fredsa/apple-color-monitor-iie-a2m2056/photos/power-pcb-bottom-flipped.jpg

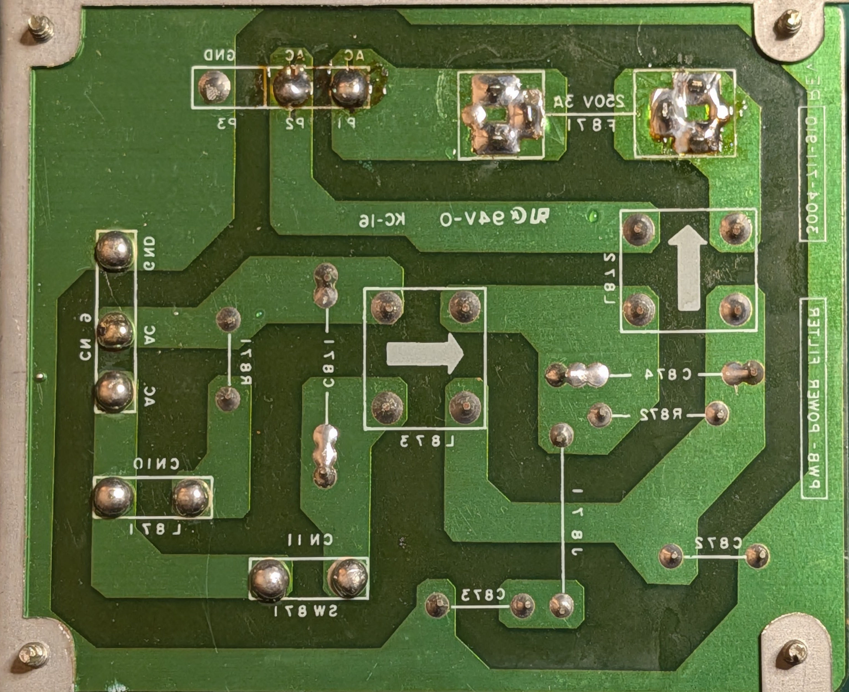
photos/power-pcb-bottom-flipped.jpg
