fredsa/apple-color-monitor-iie-a2m2056/photos/power-pcb-top.jpg

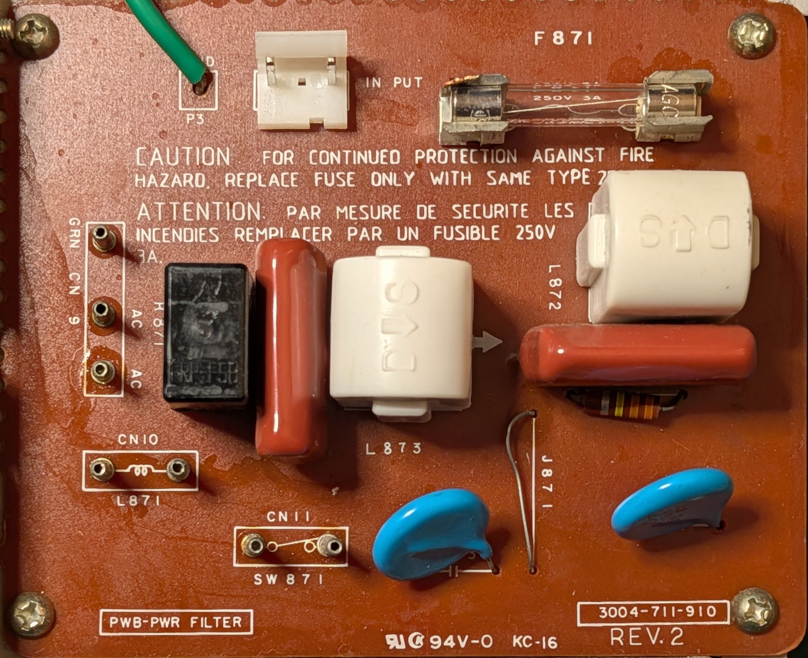
photos/power-pcb-top.jpg
