fredsa/apple-color-monitor-iie-a2m2056/apple-color-monitor-iie-a2m2056.pdf

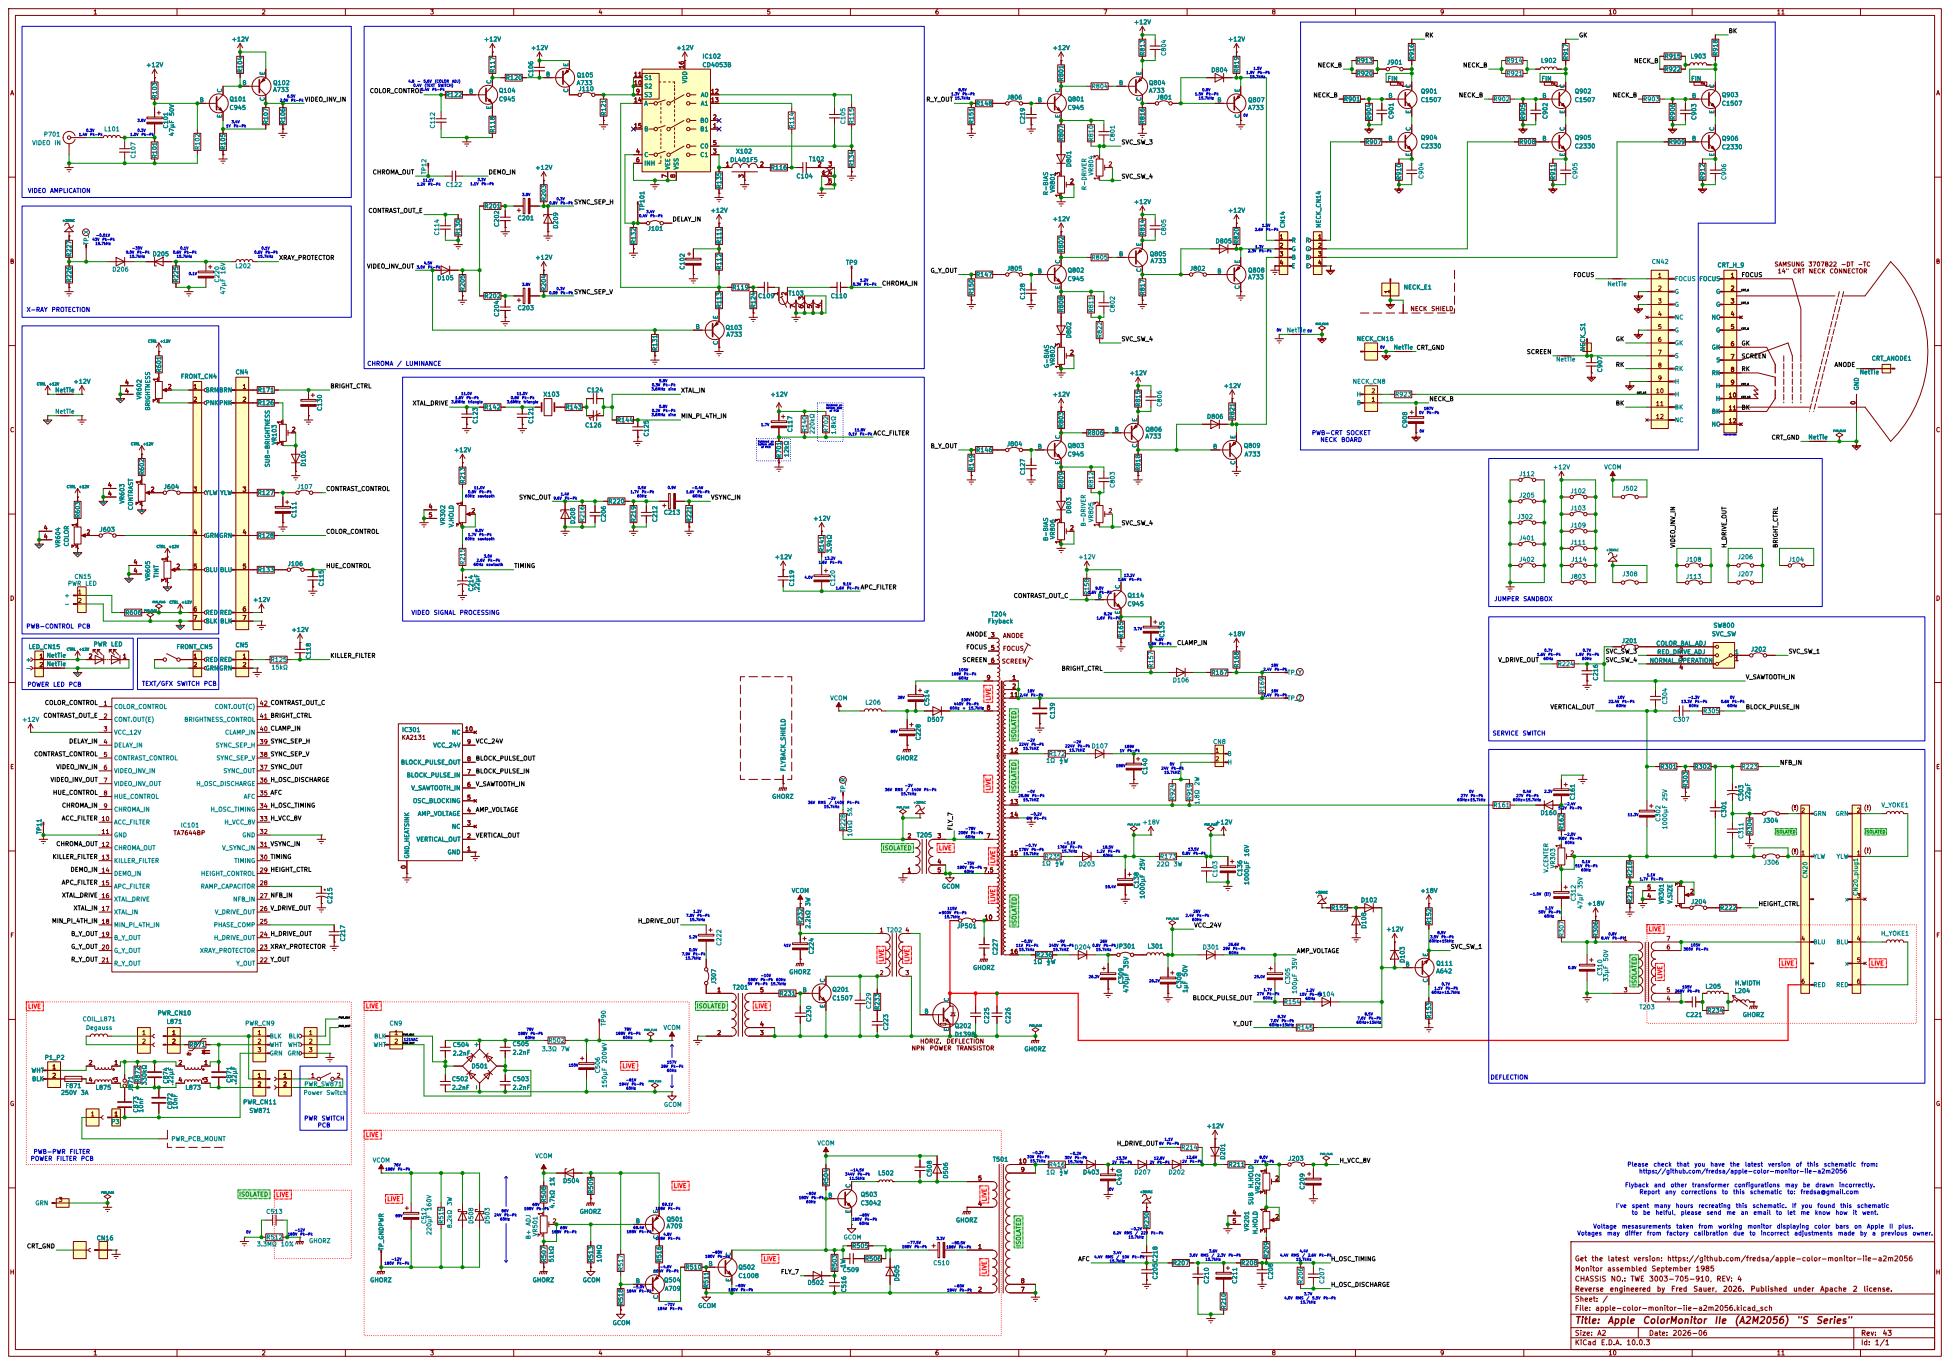
[picture p8: page 1]

8.5V 1.3V Pk-Pk 15.7kHz 0.3V 0.08 Pk-Pk

13.2V 1.6V Pk-Pk 4.0V CHROMA / LUMINANCE

Soldered on
bottom side of PCB

PWB-CRT SOCKET NECK BOARD

PWR_FLAG SW800

Soldered on bottom side of PCB

18V 2.4V Pk-Pk 8.0V 1.7V Pk-Pk 60Hz sawtooth

3.0V 2.6V Pk-Pk 60Hz sawtooth VIDEO SIGNAL PROCESSING

TEXT/GFX SWITCH PCB

0V 0.6V Pk-Pk 60Hz -10V 186V Pk-Pk 60Hz 5V Pk-Pk 15.7kHz41V

0.4V 27V Pk-Pk 60Hz+15.7kHz 1.7V 27V Pk-Pk 60Hz

GHORZ

-80V 184V Pk-Pk PWR SWITCH
PCB

Please check that you have the latest version of this schematic from: https://github.com/fredsa/apple-color-monitor-iie-a2m2056

Flyback and other transformer configurations may be drawn incorrectly.
Report any corrections to this schematic to: fredsa@gmail.com

I've spent many hours recreating this schematic. If you found this schematic

to be helful, please send me an email to let me know how it went. Voltage mesasurements taken from working monitor displaying color bars on Apple II plus.

Votages may differ from factory calibration due to incorrect adjustments made by a previous owner.

Get the latest version: https://github.com/fredsa/apple-color-monitor-iie-a2m2056
Monitor assembled September 1985
CHASSIS NO.: TWE 3003-705-910, REV: 4
Reverse engineered by Fred Sauer, 2026. Published under Apache 2 license.
Sheet: /
File: apple-color-monitor-iie-a2m2056.kicad_sch
Title: Apple ColorMonitor IIe (A2M2056) "S Series"

Size: A2 | Rev: 43
KiCad E.D.A. 10.0.3 | Id: 1/1
