fredsa/apple-color-monitor-iie-a2m2056/KiCad/apple-color-monitor-iie-a2m2056/apple-color-monitor-iie-a2m2056.kicad_pcb.pdf

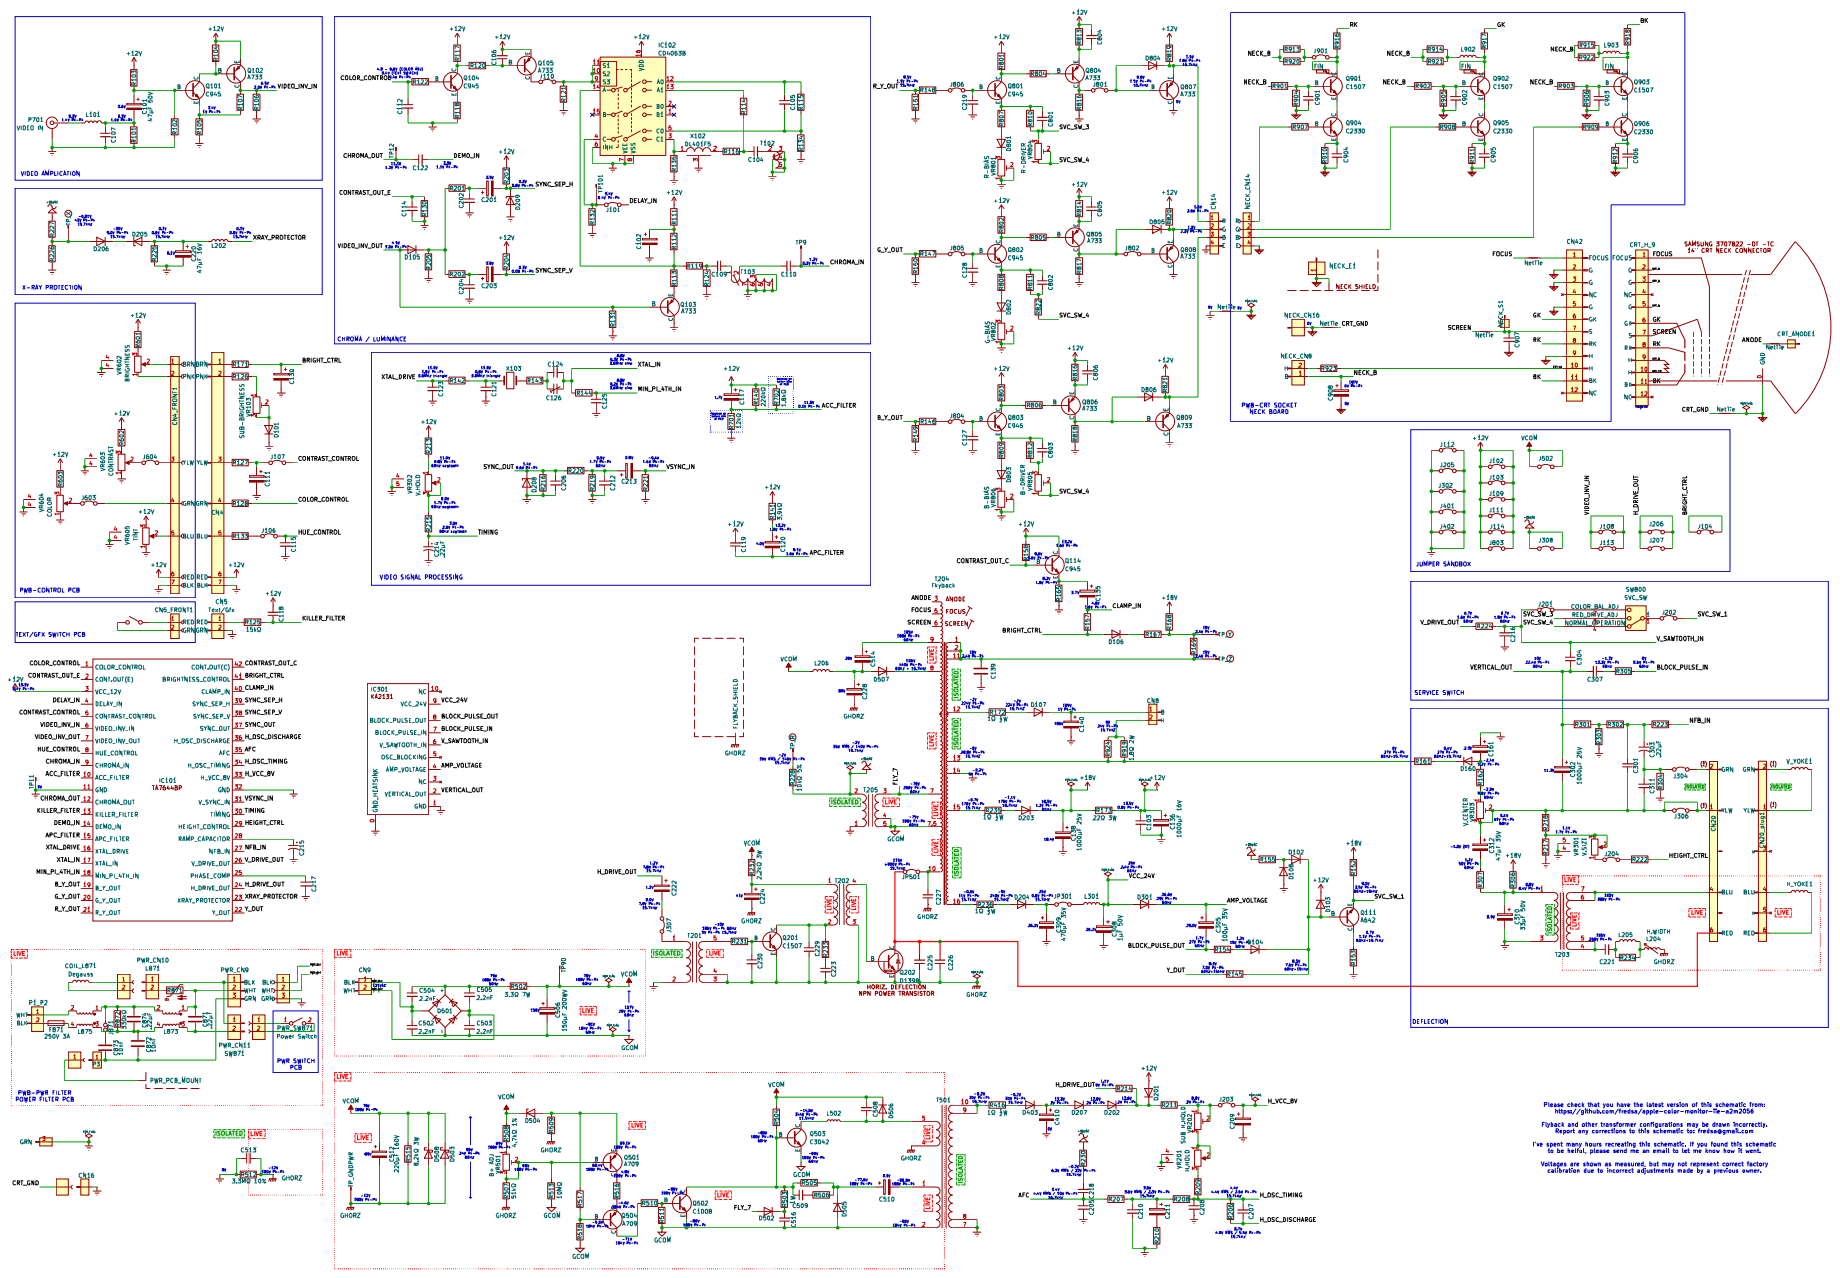
[picture p9: page 1]
