fredsa/apple-color-monitor-iie-a2m2056/KiCad/apple-color-monitor-iie-a2m2056/apple-color-monitor-iie-a2m2056.kicad_sch

## KiCad design KiCad/apple-color-monitor-iie-a2m2056/apple-color-monitor-iie-a2m2056.kicad_sch (2026-06-29)

Schematic: apple-color-monitor-iie-a2m2056.kicad_sch

Parts:
C101: 47µF 50V; CP_Radial_D5.0mm_P5.00mm
C102, C111, C117, C120, C130, C135, C140, C161, C222, C224, C410, C514: C; CP_Radial_D8.0mm_P5.00mm
C103, C104, C105, C106, C107, C109, C110, C112, C114, C115, C118, C119, C121, C122, C123, C124, C125, C127, C128, C202, C204, C205, C206, C207, C208, C210, C212, C216, C217, C218, C219, C301, C304, C307, C311, C801, C802, C803, C804, C805, C806: C_Small; R_Axial_DIN0204_L3.6mm_D1.6mm_P5.08mm_Horizontal
C126: C_Trim_Small; R_Axial_DIN0204_L3.6mm_D1.6mm_P5.08mm_Horizontal
C136: 1000µF 16V; CP_Radial_D10.0mm_P5.00mm
C138: 1000µF 25V; CP_Radial_D12.5mm_P7.50mm
C139: C; C_Axial_L3.8mm_D2.6mm_P12.50mm_Horizontal
C201, C203, C209, C211, C213, C908: C; CP_Radial_D5.0mm_P5.00mm
C214, C303: .22µF; CP_Radial_Tantal_D4.5mm_P5.00mm
C215: C; CP_Radial_Tantal_D4.5mm_P5.00mm
C220: 47µF 16V; CP_Radial_D5.0mm_P5.00mm
C221: C_Small; R_Axial_DIN0309_L9.0mm_D3.2mm_P20.32mm_Horizontal
C223, C229, C230: C_Small; C_Rect_L7.0mm_W2.5mm_P5.00mm
C225, C227: C_Small; C_Rect_L16.5mm_W4.9mm_P15.00mm_MKT
C226, C508, C509: C_Small; C_Disc_D10.0mm_W2.5mm_P5.00mm
C228: C; CP_Radial_D10.0mm_P7.50mm
C302: 1000µF 25V; CP_Radial_D10.0mm_P7.50mm
C305: 100µF 35V; CP_Radial_D8.0mm_P5.00mm
C308: 1µF 50V; CP_Radial_D8.0mm_P5.00mm
C309: 470µF 35V; CP_Radial_D10.0mm_P5.00mm
C310: 33µF 50V; CP_Radial_D8.0mm_P5.00mm
C312: 47µF 35V; CP_Radial_D8.0mm_P5.00mm
C502, C503, C504, C505: 2.2nF; C_Rect_L10.0mm_W2.5mm_P7.50mm_MKS4
C506: 150µF 200WV; CP_Radial_D16.0mm_P7.50mm
C510: C; CP_Radial_D8.0mm_P3.80mm
C512: 220µF 160V; CP_Radial_D16.0mm_P7.50mm
C513: C_Small; C_Rect_L9.0mm_W2.5mm_P7.50mm_MKT
C516: C_Small; C_Disc_D12.0mm_W4.4mm_P7.75mm
C871, C874: .22µF; R_Axial_Power_L20.0mm_W6.4mm_P25.40mm
C872, C873: 10nF; C_Axial_L3.8mm_D2.6mm_P10.00mm_Horizontal
C901, C902, C903, C904, C905, C906: C_Small; _C_Axial_P5.0mm
C907: C_Small; R_Axial_DIN0204_L3.6mm_D1.6mm_P7.62mm_Horizontal
CN4: Conn_01x07_Pin; _Molex_1x07_P2.54mm_Vertical
CN5: CN; Molex_KK-254_AE-6410-02A_1x02_P2.54mm_Vertical
CN8: Conn_01x02_Pin; SolderWire-0.127sqmm_1x02_P3.7mm_D0.48mm_OD1mm
CN9: Conn_01x02_Pin; _Conn_01x02
CN14: Conn_01x04_Pin; JST_XH_B4B-XH-AM_1x04_P2.50mm_Vertical
CN15: PWR LED; Molex_KK-254_AE-6410-02A_1x02_P2.54mm_Vertical
CN16: Conn_01x01_Pin; Pin_D1.0mm_L10.0mm
CN20: Conn_01x06_Pin; _CN20_pins
CN20_plug1: Conn_01x06
CN42: -crt-neck
COIL_L871: Degauss
CRT_ANODE1: Conn_01x01_Pin
CRT_GND1: Conn_01x01_Socket
CRT_H_9: Conn_01x12_Pin
D1: PWR LED
D101, D105, D106, D160: D; D_DO-15_P10.16mm_Horizontal
D102, D104, D108, D202, D207: D; D_DO-34_SOD68_P10.16mm_Horizontal
D103, D201: D; D_DO-34_SOD68_P12.70mm_Horizontal
D107, D301, D502, D506, D507: D; D_DO-15_P12.70mm_Horizontal
D203, D204, D403, D505: D; D_DO-15_P15.24mm_Horizontal
D205, D208, D209, D504: D_Zener; _ZenerDiode_P10mm
D206: D; _D_P14.5mm
D501: VALUE; _DiodeBridge
D503, D508: D_Schottky; _SchotkyDiode_P17.5mm
D801, D802, D803, D804, D805, D806: D; D_5W_P10.16mm_Horizontal
F871: 250V 3A; Fuseholder_Clip-6.3x32mm_Littelfuse_102071_Inline_P34.70x7.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
FRONT_CN4: CN; -connector_front_controls_01x07
FRONT_CN5: Conn_01x02_Socket
G_CN9: Conn_01x01_Pin; Pin_D1.0mm_L10.0mm
H_YOKE1: L
IC101: DIP-42_W15.24mm_LongPads
IC102: CD4053B; DIP-16_W7.62mm_LongPads
IC301: (no value)
J101, J102, J104, J106, J107, J114, J201, J202, J402, J604: Jumper_2_Bridged; _Jumper_11mm
J103, J401: Jumper_2_Bridged; _Jumper_12mm
J108, J109, J110, J111, J113, J302, J304, J306, J307, J308, J502, J803: Jumper_2_Bridged; _Jumper_13mm
J112, J204, J205, J206, J804, J805, J806: Jumper_2_Bridged; _Jumper_15mm
J203, J871: Jumper_2_Bridged; _Jumper_20mm
J207, J603, J801, J802: Jumper_2_Bridged; _Jumper_10mm
J901: Jumper_2_Bridged; _Jumper_4mm
JP301, JP501: Jumper_2_Bridged; _Jumper_13mm
L101, L205: L; L_Radial_D12.0mm_P6.00mm_Murata_1900R
L202: L; _L_Horiz_P6mm
L204: H.WIDTH; Potentiometer_Piher_PT-15-V02_Vertical
L206, L301: L; L_Radial_D12.5mm_P7.00mm_Fastron_09HCP
L502: L_Small; L_Axial_L11.0mm_D4.5mm_P15.24mm_Horizontal_Fastron_MECC
L873, L875: L_Coupled; _choke-pwr-board
L902, L903: L; _L_Axial_P5.0mm
LED_CN15: Conn_01x02_Socket
NECK_CN8: Conn_01x02_Pin; SolderWire-0.127sqmm_1x02_P3.7mm_D0.48mm_OD1mm
NECK_CN14: Conn_01x04_Socket; Molex_KK-254_AE-6410-04A_1x04_P2.54mm_Vertical
NECK_CN16: Conn_01x01_Pin; Pin_D1.0mm_L10.0mm
NECK_E1: Conn_01x01_Pin; -SolderWire
NECK_S1: Conn_01x01_Pin; -SolderWire
NECK_SH1: Metal Shield; Laird_Technologies_BMI-S-103_26.21x26.21mm
NT1, NT2, NT3, NT4, NT5, NT6, NT7, NT8, NT9, NT10: NetTie
P1_P2: IN PUT; -Connector_01x02XP10.0mm
P3: Conn_01x01_Pin; -SolderWire
P701: VIDEO IN; SMA_Amphenol_901-143_Horizontal
PWR_CN9: Conn_01x03_Pin; -Connector_01x03
PWR_CN10: L871; -Connector_01x02XP10.0mm
PWR_CN11: SW871; -Connector_01x02XP10.0mm
PWR_SW871: Power Switch
Q101, Q104, Q114, Q801, Q802, Q803: C945; -Transistor_EBC-NPN
Q102, Q103, Q105, Q804, Q805, Q806, Q807, Q808, Q809: A733; -Transistor_EBC-PNP
Q111: A642; -Transistor_EBC-NPN
Q201: C1507; TO-220-3_Vertical
Q202: D1398; TO-3P-3_Vertical
Q501, Q504: A709; -Transistor_EBC-PNP
Q502: C1008; -Transistor_EBC-NPN
Q503: C3042; _TO-3P-3_Vertical_BCE
Q901, Q902, Q903: C1507; -TO-220-3_Vertical-BCE_FIN
Q904, Q905, Q906: C2330; -Transistor_ECB-NPN
R101, R102, R103, R104, R105, R106, R107, R111, R112, R113, R114, R115, R116, R117, R118, R119, R120, R121, R124, R127, R128, R130, R131, R132, R133, R134, R135, R142, R143, R144, R149, R150, R151, R153, R155, R157, R161, R165, R168, R169, R171, R201, R202, R205, R206, R207, R208, R209, R210, R213, R217, R218, R222, R223, R224, R225, R226, R227, R231, R302, R303, R305, R506, R509, R510, R511, R516, R517, R518, R601, R602, R603, R606, R801, R802, R803, R804, R805, R806, R807, R808, R809, R810, R811, R812, R813, R814, R815, R816, R817, R818, R819, R820, R821, R822, R901, R902, R903, R904, R905, R906, R907, R908, R909, R910, R911, R912, R924: R; R_Axial_DIN0207_L6.3mm_D2.5mm_P10.16mm_Horizontal
R122, R154, R167, R203, R204, R214, R234, R304, R306, R307, R917: R; R_Axial_DIN0207_L6.3mm_D2.5mm_P15.24mm_Horizontal
R125: 15kΩ; R_Axial_DIN0207_L6.3mm_D2.5mm_P10.16mm_Horizontal
R126, R146, R147, R148, R152, R158, R162, R211, R215, R230, R233, R301, R505, R916, R918, R920, R922, R923: R; R_Axial_DIN0309_L9.0mm_D3.2mm_P12.70mm_Horizontal
R140: 220kΩ; R_Axial_DIN0207_L6.3mm_D2.5mm_P10.16mm_Horizontal
R141: 3.9kΩ; R_Axial_DIN0207_L6.3mm_D2.5mm_P10.16mm_Horizontal
R145: R; _R_Axial_P17.0mm
R172, R235, R236, R416: 1Ω ½W; _R_Axial_P17.0mm
R173: 22Ω 3W; _R_Axial_P27.0mm
R216, R219, R220, R221, R921: R; R_Axial_P11.0mm
R228: 10kΩ 5%; R_Axial_DIN0207_L6.3mm_D2.5mm_P10.16mm_Horizontal
R232: 2.2kΩ 3W; _R_Axial_P27.0mm
R502: 3.3Ω 7W; _R_Axial_P20.0mm
R503: 1W; R_Axial_DIN0309_L9.0mm_D3.2mm_P25.40mm_Horizontal
R504: R; R_Axial_DIN0414_L11.9mm_D4.5mm_P15.24mm_Horizontal
R507: 51kΩ; R_Axial_DIN0207_L6.3mm_D2.5mm_P10.16mm_Horizontal
R508: 4.7kΩ 1%; R_Axial_DIN0207_L6.3mm_D2.5mm_P10.16mm_Horizontal
R512: 3.3MΩ 10%; R_Axial_DIN0207_L6.3mm_D2.5mm_P15.24mm_Horizontal
R513: 10MΩ; R_Axial_DIN0207_L6.3mm_D2.5mm_P10.16mm_Horizontal
R515: 8.2kΩ 3W; _R_Axial_P27.0mm
R701: 12kΩ; R_Axial_DIN0309_L9.0mm_D3.2mm_P20.32mm_Horizontal
R702: 1.8kΩ; R_Axial_DIN0309_L9.0mm_D3.2mm_P20.32mm_Horizontal
R871: Thermistor_PTC; R_Box_L13.0mm_W4.0mm_P9.00mm
R872: 330kΩ; R_Axial_DIN0207_L6.3mm_D2.5mm_P15.24mm_Horizontal
R913, R914, R915: R; R_Axial_side_shift_P20.32mm
R919: 1.8Ω 2W; R_Axial_DIN0309_L9.0mm_D3.2mm_P20.32mm_Horizontal
SH1, SH2: RFShield_OnePiece; Laird_Technologies_BMI-S-103_26.21x26.21mm
SW1: SW_SPST
SW800: SVC_SW; _SVC_SWITCH_1P3T
T102, T103, T201, T205: Transformer_1P_1S; _Transformer_Isolation_10x12mm
T202: Transformer_1P_1S; _Transformer_Isolation_7x7mm
T203: Transformer_SP_2S; Transformer_Breve_TEZ-22x24
T204: Fkyback; _my_flyback
T501: Transformer_4_5_Unknwon; Transformer_Breve_TEZ-28x33
TP9, TP11, TP12, TP90, TP101: Conn_01x01_Pin; Pin_D1.0mm_L10.0mm
TPR1: -testpoint
TPX1: -testpoint
TPY1: -testpoint
TPZ1: -testpoint
TP_GNDPWR1: Conn_01x01_Pin; Pin_D1.0mm_L10.0mm
VR103: SUB-BRIGHTNESS; _Potentiometer_5x5mm
VR201: H.HOLD; _Pot_rear
VR202: SUB H.HOLD; Potentiometer_Piher_PT-10-V10_Vertical
VR301: V.SIZE; _Pot_rear
VR302: V.HOLD; _Pot_rear
VR303: V.CENTER; _Potentiometer_5x5mm
VR501: B+ ADJ; Potentiometer_Piher_PT-10-V10_Vertical
VR602: BRIGHTNESS; _Pot_front
VR603: CONTRAST; _Pot_front
VR604: COLOR; _Pot_front
VR605: TINT; _Pot_front
VR801: R-BIAS; _Potentiometer_5x5mm
VR802: G-BIAS; _Potentiometer_5x5mm
VR804: R-DRIVER; _Potentiometer_5x5mm
VR805: B-DRIVER; _Potentiometer_5x5mm
VR806: B-BIAS; _Potentiometer_5x5mm
V_YOKE1: L
WIRE_CN9: Conn_01x03_Socket
WIRE_CN10, WIRE_CN11: Conn_01x02_Socket
WIRE_P3: Conn_01x01_Socket
X102: DL401F5; _DelayLine_3_pin_P14mm
X103: Crystal; Resonator-2Pin_W6.0mm_H3.0mm

Connections:
+12V: C103.1, C106.2, C117.1, C118.2, C119.2, C136.1, C804.2, C805.1, C806.2, CN4.6 (RED), D103.1 (K), D201.2 (A), IC101.3 (VCC_12V), IC102.16 (VDD), J102.1 (A), J102.2 (B), J103.1 (A), J103.2 (B), J109.1 (A), J109.2 (B), J111.1 (A), J111.2 (B), J114.1 (A), J114.2 (B), J803.1 (A), J803.2 (B), NT10.2, Q102.1 (E), Q105.1 (E), Q114.3 (C), R103.2, R104.2, R111.1, R117.1, R140.1, R141.1, R158.2, R173.1, R203.1, R204.1, R213.1, R702.2, R801.1, R802.1, R803.2, R813.2, R814.2, R815.2, R819.1, R820.1, R821.1
+18V: C138.1, D203.1 (K), R152.1, R168.1, R173.2, R306.2
+36VAC: J308.1 (A), J308.2 (B), R155.2, R227.1, R228.1, R230.2, T205.2 (AB)
ACC_FILTER: C117.2, IC101.10 (ACC_FILTER), R140.2, R701.1, R702.1
AFC: C205.1, C218.1, IC101.35 (AFC), R207.2
AMP_VOLTAGE: C305.1, D301.1 (K), IC301.4 (AMP_VOLTAGE)
ANODE: NT3.1, T204.3 (ANODE)
APC_FILTER: C119.1, C120.2, IC101.15 (APC_FILTER)
BK: CN42.11 (BK), CRT_H_9.11 (BK), R918.2
BLOCK_PULSE_IN: IC301.7 (BLOCK_PULSE_IN), R305.1
BLOCK_PULSE_OUT: C305.2, IC301.8 (BLOCK_PULSE_OUT), R154.1
BRIGHT_CTRL: C130.1, D106.2 (A), IC101.41 (BRIGHTNESS_CONTROL), J104.1 (A), J104.2 (B), R157.1, R171.1
B_Y_OUT: IC101.19 (B_Y_OUT), R146.2, R149.1
CHROMA_IN: C110.1, IC101.9 (CHROMA_IN), TP9.1
CHROMA_OUT: C122.1, IC101.12 (CHROMA_OUT), TP12.1
CLAMP_IN: C135.2, IC101.40 (CLAMP_IN), R157.2
COLOR_CONTROL: C112.1, IC101.1 (COLOR_CONTROL), R122.1, R128.2
CONTRAST_CONTROL: IC101.5 (CONTRAST_CONTROL), J107.1 (A)
CONTRAST_OUT_C: IC101.42 (CONT.OUT(C)), Q114.2 (B), R158.1
CONTRAST_OUT_E: C114.1, IC101.2 (CONT.OUT(E)), R130.1
CRT_10: CN42.10 (H), CRT_H_9.10 (H), R923.2
CRT_G: CRT_H_9.2 (G), CRT_H_9.3 (G), CRT_H_9.5 (G), CRT_H_9.9 (H)
CRT_GND: CRT_GND1.1, NT5.2, NT7.1
CTRL: CN15.2 (-), D1.1 (K), FRONT_CN4.7 (BLK), NT8.2, NT9.1, VR602.4, VR603.3, VR603.4, VR604.3, VR604.4, VR605.3, VR605.4
CTRL +12V: D1.2 (A), FRONT_CN4.6 (RED), NT6.2, NT10.1, R601.2, R602.1, R603.2, R606.1, VR605.1
DELAY_IN: IC101.4 (DELAY_IN), J101.1 (A)
DEMO_IN: C122.2, IC101.14 (DEMO_IN)
FLY_7: D502.2 (A), T204.7, T205.3 (SA)
FOCUS: CRT_H_9.1 (FOCUS), NT2.1, T204.5 (FOCUS)
GCOM: C502.2, C503.2, C506.2, C516.1, D501.3 (-), D505.2 (A), Q502.1 (E), Q503.3 (E), R511.1, R513.1, R518.1, T204.7.5, T205.4 (SA), T205.5 (SB), T501.2 (PB)
GHORZ: C223.2, C224.2, C225.1, C226.1, C227.1, C228.2, C229.2, C230.2, C512.2, C513.2, D503.2 (A), D508.2 (A), L204.2, Q201.3 (E), Q202.3 (E), R507.2, R509.2, R512.1, R515.1, SH1.1, T201.3 (SA), T201.4 (SA), T202.3 (SA), T501.4 (PD), TP_GNDPWR1.TP
GK: CN42.6 (GK), CRT_H_9.6 (GK), R917.1
GND1: C901.2, C902.2, C903.2, C904.2, C905.2, C906.1, C908.2, NECK_CN14.4 (E), NECK_E1.1, NECK_SH1.1, NT1.2, R904.1, R905.1, R906.2, R910.1, R911.1, R912.1
GND2: C907.2, CN42.2 (G), CN42.3 (G), CN42.5 (G), CN42.9 (H), CRT_H_9.0 (GND), NECK_CN16.1, NT5.1, NT7.2
GNDREF: C102.2, C103.2, C107.2, C111.2, C112.2, C114.2, C115.2, C121.2, C123.2, C125.2, C127.2, C128.2, C130.2, C136.2, C138.2, C139.2, C140.2, C161.1, C202.2, C204.2, C205.2, C206.2, C208.2, C209.2, C210.2, C212.2, C214.2, C215.2, C216.1, C217.2, C219.2, C220.2, C308.2, C309.2, C310.2, C410.2, C513.1, CN4.7 (BLK), CN5.2 (GRN), CN14.4 (E), CN16.1, D101.1 (K), D108.2 (A), D208.2 (A), D209.2 (A), G_CN9.3, IC101.11 (GND), IC101.32 (GND), IC102.6 (INH), IC102.7 (VEE), IC102.8 (VSS), IC301.0 (GND_HEATSINK), IC301.1 (GND), J112.1 (A), J112.2 (B), J205.1 (A), J205.2 (B), J302.1 (A), J302.2 (B), J401.1 (A), J401.2 (B), J402.1 (A), J402.2 (B), NT1.1, NT9.2, P701.2 (Ext), Q103.3 (C), Q807.3 (C), Q808.3 (C), Q809.3 (C), R101.2, R102.2, R105.2, R106.1, R118.2, R121.1, R124.1, R130.2, R131.2, R132.1, R134.1, R135.1, R149.2, R150.2, R151.2, R153.1, R165.1, R205.1, R210.2, R216.1, R217.1, R219.1, R221.1, R225.2, R226.2, R303.1, R304.1, R512.2, R701.2, R816.1, R817.1, R818.1, T102.1 (AA), T102.3 (SB), T102.4 (SA), T102.5 (SA), T103.3 (SA), T103.4 (SA), T103.5 (SB), T103.6 (SB), T103.7 (SB), T201.2 (AB), T203.3 (IN-), T204.14, T205.1 (AA), T501.7 (SD), T501.8 (SC), TP11.1, VR201.4 (GND1), VR201.5 (GND2), VR301.4 (GND1), VR301.5 (GND2), VR302.4 (GND1), VR302.5 (GND2), VR801.1, VR801.2, VR802.1, VR802.2, VR806.1, VR806.2, WIRE_CN9.3 (GRN), X102.3 (COMMUN)
G_Y_OUT: IC101.20 (G_Y_OUT), R147.1, R150.1
HEIGHT_CTRL: IC101.29 (HEIGHT_CONTROL), R222.2
HUE_CONTROL: C115.1, IC101.8 (HUE_CONTROL), J106.2 (B)
H_DRIVE_OUT: C222.1, IC101.24 (H_DRIVE_OUT), J206.1 (A), J206.2 (B), J207.1 (A), J207.2 (B), R214.1
H_OSC_DISCHARGE: C207.1, IC101.36 (H_OSC_DISCHARGE), R206.1
H_OSC_TIMING: C207.2, C208.1, IC101.34 (H_OSC_TIMING), R206.2, R208.2, R209.2
H_VCC_8V: C209.1, IC101.33 (H_VCC_8V), J203.2 (B)
KILLER_FILTER: C118.1, IC101.13 (KILLER_FILTER), R125.1
MIN_PI_4TH_IN: C125.1, IC101.18 (MIN_PI_4TH_IN), R144.1
NECK_B: C908.1, NECK_CN8.1 (B), R901.2, R902.1, R903.1, R913.1, R914.1, R915.2, R920.1, R921.2, R922.1
NFB_IN: IC101.27 (NFB_IN), R223.2
unnamed: C101.1, Q101.2 (B), R102.1, R103.1
unnamed: C101.2, C107.1, L101.2, R101.1
unnamed: C102.1, R111.2, R112.1
unnamed: C104.1, R114.1, R116.2
unnamed: C104.2, T102.2 (AB)
unnamed: C105.1, IC102.12 (A0), R115.2
unnamed: C105.2, IC102.5 (C0), R115.1, R134.2
unnamed: C106.1, Q105.2 (B), R120.1
unnamed: C109.1, T103.1 (AA)
unnamed: C109.2, R119.2, R124.2
unnamed: C110.2, T103.2 (AB)
unnamed: C111.1, J107.2 (B), R127.2
unnamed: C120.1, R141.2
unnamed: C121.1, R142.2, X103.2
unnamed: C124.1, C126.1, R143.2
unnamed: C127.1, J804.1 (A), Q803.2 (B)
unnamed: C128.1, J805.1 (A), Q802.2 (B)
unnamed: C135.1, Q114.1 (E), R165.2
unnamed: C139.1, R169.2, T204.1, T204.2, T204.11, TPZ1.TP
unnamed: C140.1, CN8.1 (B), D107.1 (K)
unnamed: C161.2, D160.2 (A), R162.1
unnamed: C201.1, C202.1, R201.1
unnamed: C203.1, C204.1, R202.1
unnamed: C210.1, C211.1, R207.1, R208.1
unnamed: C211.2, R210.1
unnamed: C212.1, C213.1, R219.2, R220.2
unnamed: C215.1, IC101.28 (RAMP_CAPACITOR)
unnamed: C217.1, IC101.25 (PHASE_COMP)
unnamed: C218.2, R230.1
unnamed: C219.1, J806.1 (A), Q801.2 (B)
unnamed: C220.1, D205.2 (A), L202.1, R225.1
unnamed: C221.1, T203.4 (OUT2B), T203.5 (OUT2A)
unnamed: C221.2, L205.1, R234.2
unnamed: C222.2, J307.1 (A)
unnamed: C223.1, R233.2
unnamed: C224.1, R232.1, T202.1 (AA)
unnamed: C225.2, C226.2, CN20.6 (RED), JP501.1 (A), Q202.2 (C)
unnamed: C227.2, JP501.2 (B), T204.10
unnamed: C228.1, C514.2, D507.2 (A), L206.2
unnamed: C229.1, Q201.2 (C), R233.1, T202.2 (AB)
unnamed: C230.1, Q201.1 (B), R231.2
unnamed: C301.1, C302.2, C311.2, C312.1, CN20.1 (YLW), J306.1 (A), J306.2 (B), R218.2, VR303.2, VR303.3
unnamed: C301.2, C303.1, R223.1, R302.2
unnamed: C303.2, C311.1, J304.1 (A), R304.2
unnamed: C307.1, R305.2
unnamed: C309.1, D204.1 (K), JP301.2 (B)
unnamed: C310.1, R306.1, R307.2, T203.1 (IN+)
unnamed: C312.2, R307.1
unnamed: C410.1, D207.2 (A), D403.1 (K)
unnamed: C504.1, C505.1, D501.2 (+), R502.2
unnamed: C508.1, D506.2 (A), L502.1, T501.5 (PC)
unnamed: C509.1, Q502.3 (C), Q503.1 (B), R503.1, R504.1, R505.2
unnamed: C509.2, R506.1
unnamed: C510.1, D505.1 (K), R505.1, R506.2
unnamed: C510.2, T501.1 (PA)
unnamed: C514.1, T204.9
unnamed: C516.2, D502.1 (K), R503.2
unnamed: C801.2, Q801.1 (E), R807.1, R810.2
unnamed: C802.1, Q802.1 (E), R808.1, R811.1
unnamed: C802.2, R811.2, R822.1
unnamed: C803.1, Q803.1 (E), R809.1, R812.1
unnamed: C803.2, R812.2, VR805.3
unnamed: C804.1, Q804.1 (E), R813.1
unnamed: C805.2, Q805.1 (E), R814.1
unnamed: C806.1, Q806.1 (E), R815.1
unnamed: C871.1, L873.3, PWR_CN11.2
unnamed: C871.2, L873.1, PWR_CN9.2 (WHT), R871.2
unnamed: C872.1, C873.2, P3.1, PWR_CN9.3 (GRN)
unnamed: C872.2, C874.1, L873.4, L875.3, R872.1
unnamed: C873.1, J871.2 (B)
unnamed: C874.2, J871.1 (A), L873.2, L875.1, R872.2
unnamed: C901.1, Q901.1 (B), R901.1, R904.2
unnamed: C902.1, Q902.1 (B), R902.2, R905.2
unnamed: C903.1, Q903.1 (B), R903.2, R906.1
unnamed: C904.1, Q904.1 (E), R910.2
unnamed: C905.1, Q905.1 (E), R911.2
unnamed: C906.2, Q906.1 (E), R912.2
unnamed: C907.1, CN42.7 (S), NECK_S1.1, NT4.2
unnamed: CN4.1 (BRN), R171.2
unnamed: CN4.2 (PNK), R126.2
unnamed: CN4.3 (YLW), R127.1
unnamed: CN4.4 (GRN), R128.1
unnamed: CN4.5 (BLU), R133.2
unnamed: CN5.1 (RED), R125.2
unnamed: CN8.2 (H), R919.2, R924.2
unnamed: CN14.1 (R), D804.1 (K), Q807.1 (E), R819.2
unnamed: CN14.2 (G), D805.1 (K), Q808.1 (E), R820.2
unnamed: CN14.3 (B), D806.1 (K), Q809.1 (E), R821.2
unnamed: CN15.1 (+), R606.2
unnamed: CN20.2 (GRN), J304.2 (B)
unnamed: CN20.4 (BLU), T203.6 (OUT1B), T203.7 (OUT1A)
unnamed: CN20_plug1.1 (YLW), V_YOKE1.2
unnamed: CN20_plug1.2 (GRN), V_YOKE1.1
unnamed: CN20_plug1.4 (BLU), H_YOKE1.1
unnamed: CN20_plug1.6 (RED), H_YOKE1.2
unnamed: CN42.1 (FOCUS), NT2.2
unnamed: COIL_L871.1, WIRE_CN10.1
unnamed: COIL_L871.2, WIRE_CN10.2
unnamed: CRT_ANODE1.1, NT3.2
unnamed: D101.2 (A), VR103.2, VR103.3
unnamed: D102.1 (K), D103.2 (A), D104.1 (K), Q111.2 (B), R145.2
unnamed: D102.2 (A), D108.1 (K), R155.1
unnamed: D104.2 (A), R154.2
unnamed: D105.1 (K), R201.2, R202.2, R205.2
unnamed: D106.1 (K), R167.2
unnamed: D107.2 (A), R172.2
unnamed: D160.1 (K), R161.1
unnamed: D201.1 (K), D202.1 (K), R211.2, R214.2
unnamed: D202.2 (A), D207.1 (K)
unnamed: D203.2 (A), R235.2
unnamed: D204.2 (A), R236.2
unnamed: D205.1 (K), D206.1 (K)
unnamed: D206.2 (A), R226.1, R227.2, TPX1.TP
unnamed: D403.2 (A), R416.2
unnamed: D504.2 (A), Q501.1 (E), R509.1, R517.1
unnamed: D507.1 (K), T204.8
unnamed: D801.1 (K), VR801.3
unnamed: D801.2 (A), R807.2
unnamed: D802.1 (K), VR802.3
unnamed: D802.2 (A), R808.2
unnamed: D803.1 (K), VR806.3
unnamed: D803.2 (A), R809.2
unnamed: D804.2 (A), J801.1 (A), Q807.2 (B)
unnamed: D805.2 (A), J802.1 (A), Q805.3 (C), R817.2
unnamed: D806.2 (A), Q806.3 (C), Q809.2 (B), R818.2
unnamed: F871.1, P1_P2.2 (BLK)
unnamed: F871.2, L875.4
unnamed: FRONT_CN4.1 (BRN), VR602.2
unnamed: FRONT_CN4.2 (PNK), VR602.3
unnamed: FRONT_CN4.3 (YLW), J604.2 (B)
unnamed: FRONT_CN4.4 (GRN), J603.2 (B)
unnamed: FRONT_CN4.5 (BLU), VR605.2
unnamed: FRONT_CN5.1 (RED), SW1.1 (A)
unnamed: FRONT_CN5.2 (GRN), SW1.2 (B)
unnamed: IC102.3 (C1), R135.2, X102.1
unnamed: IC102.4 (C), J101.2 (B), R132.2, TP101.1
unnamed: IC102.9 (S3), IC102.10 (S2), IC102.11 (S1), J110.2 (B), R121.2
unnamed: IC102.13 (A1), R114.2
unnamed: IC102.14 (A), R112.2, R113.2, R119.1
unnamed: J106.1 (A), R133.1
unnamed: J110.1 (A), Q105.3 (C)
unnamed: J201.2 (B), SW800.2 (COLOR_BAL_ADJ)
unnamed: J202.2 (B), SW800.1
unnamed: J203.1 (A), R211.1, VR202.1, VR202.2
unnamed: J204.1 (A), R222.1
unnamed: J204.2 (B), VR301.1
unnamed: J307.2 (B), T201.1 (AA)
unnamed: J603.1 (A), VR604.2
unnamed: J604.1 (A), VR603.2
unnamed: J801.2 (B), Q804.3 (C), R816.2
unnamed: J802.2 (B), Q808.2 (B)
unnamed: J804.2 (B), R146.1
unnamed: J805.2 (B), R147.2
unnamed: J806.2 (B), R148.2
unnamed: J901.1 (A), R913.2, R920.2
unnamed: J901.2 (B), Q901.2 (FIN), R916.1
unnamed: JP301.1 (A), L301.2
unnamed: L101.1, P701.1 (In)
unnamed: L204.1, L205.2, R234.1
unnamed: L502.2, Q503.2 (C)
unnamed: L875.2, P1_P2.1 (WHT)
unnamed: L902.1, Q902.2 (FIN), R917.2
unnamed: L902.2, R914.2, R921.1
unnamed: L903.1, R915.1, R922.2
unnamed: L903.2, Q903.2 (FIN), R918.1
unnamed: LED_CN15.1 (+), NT6.1
unnamed: LED_CN15.2 (-), NT8.1
unnamed: NECK_CN8.2 (H), R923.1
unnamed: NECK_CN14.1 (R), R907.1
unnamed: NECK_CN14.2 (G), R908.2
unnamed: NECK_CN14.3 (B), R909.1
unnamed: PWR_CN9.1 (BLK), PWR_CN10.1, PWR_CN11.1
unnamed: PWR_CN10.2, R871.1
unnamed: PWR_SW871.1 (A), WIRE_CN11.1
unnamed: PWR_SW871.2 (B), WIRE_CN11.2
unnamed: Q101.1 (E), R105.1, R107.1
unnamed: Q101.3 (C), Q102.2 (B), R104.1
unnamed: Q103.1 (E), R113.1
unnamed: Q104.1 (E), R118.1
unnamed: Q104.2 (B), R122.2
unnamed: Q104.3 (C), R117.2, R120.2
unnamed: Q111.3 (C), R153.2
unnamed: Q202.1 (B), T202.4 (SB)
unnamed: Q501.2 (B), R507.1, R513.2, VR501.2, VR501.3
unnamed: Q501.3 (C), R516.1
unnamed: Q502.2 (B), R510.2, R511.2
unnamed: Q504.1 (E), R516.2
unnamed: Q504.2 (B), R517.2, R518.2
unnamed: Q504.3 (C), R510.1
unnamed: Q801.3 (C), R801.2, R804.2
unnamed: Q802.3 (C), R802.2, R805.1
unnamed: Q803.3 (C), R803.1, R806.2
unnamed: Q804.2 (B), R804.1
unnamed: Q805.2 (B), R805.2
unnamed: Q806.2 (B), R806.1
unnamed: Q901.3 (E), Q904.2 (C)
unnamed: Q902.3 (E), Q905.2 (C)
unnamed: Q903.3 (E), Q906.2 (C)
unnamed: Q904.3 (B), R907.2
unnamed: Q905.3 (B), R908.1
unnamed: Q906.3 (B), R909.2
unnamed: R116.1, X102.2
unnamed: R126.1, VR103.1
unnamed: R143.1, X103.1
unnamed: R161.2, R919.1, R924.1, T204.13
unnamed: R162.2, VR303.1
unnamed: R167.1, R168.2, R169.1, TPY1.TP
unnamed: R172.1, T204.12
unnamed: R209.1, VR201.3
unnamed: R213.2, VR302.1
unnamed: R215.1, VR302.2, VR302.3
unnamed: R217.2, R218.1, VR301.2, VR301.3
unnamed: R228.2, TPR1.TP
unnamed: R231.1, T201.5 (SB)
unnamed: R235.1, T204.15
unnamed: R236.1, T204.16
unnamed: R301.1, R302.1, R303.2
unnamed: R416.1, T501.9 (SB), T501.10 (SA)
unnamed: R508.2, VR501.1
unnamed: R601.1, VR602.1
unnamed: R602.2, VR603.1
unnamed: R603.1, VR604.1
unnamed: SH2.1, WIRE_P3.1
unnamed: VR201.1, VR201.2, VR202.3
PWR_BLK: C502.1, C504.2, CN9.1 (BLK), D501.1, WIRE_CN9.1 (BLK)
PWR_WHT: C503.1, C505.2, CN9.2 (WHT), D501.4, WIRE_CN9.2 (WHT)
RK: CN42.8 (RK), CRT_H_9.8 (RK), R916.2
R_Y_OUT: IC101.21 (R_Y_OUT), R148.1, R151.1
SCREEN: CRT_H_9.7 (S), NT4.1, T204.6 (SCREEN)
SVC_SW_1: J202.1 (A), Q111.1 (E), R152.2
SVC_SW_3: C801.1, R810.1, SW800.3 (RED_DRIVE_ADJ), VR804.3
SVC_SW_4: R822.2, SW800.4 (NORMAL_OPERATION), VR804.1, VR804.2, VR805.1, VR805.2
SYNC_OUT: C206.1, D208.1 (K), IC101.37 (SYNC_OUT), R216.2, R220.1
SYNC_SEP_H: C201.2, D209.1 (K), IC101.39 (SYNC_SEP_H), R203.2
SYNC_SEP_V: C203.2, IC101.38 (SYNC_SEP_V), R204.2
TIMING: C214.1, IC101.30 (TIMING), R215.2
VCC_24V: C308.1, D301.2 (A), IC301.9 (VCC_24V), L301.1
VCOM: C506.1, C508.2, C512.1, D503.1 (K), D504.1 (K), D506.1 (K), D508.1 (K), J502.1 (A), J502.2 (B), L206.1, R232.2, R502.1, R504.2, R508.1, R515.2, TP90.1
VERTICAL_OUT: C302.1, C304.2, C307.2, IC301.2 (VERTICAL_OUT), R301.2
VIDEO_INV_IN: IC101.6 (VIDEO_INV_IN), J108.1 (A), J108.2 (B), J113.1 (A), J113.2 (B), Q102.3 (C), R106.2, R107.2
VIDEO_INV_OUT: D105.2 (A), IC101.7 (VIDEO_INV_OUT), Q103.2 (B), R131.1
VSYNC_IN: C213.2, IC101.31 (V_SYNC_IN), R221.2
V_DRIVE_OUT: IC101.26 (V_DRIVE_OUT), R224.2
V_SAWTOOTH_IN: C216.2, C304.1, IC301.6 (V_SAWTOOTH_IN), J201.1 (A), R224.1
XRAY_PROTECTOR: IC101.23 (XRAY_PROTECTOR), L202.2
XTAL_DRIVE: C123.1, IC101.16 (XTAL_DRIVE), R142.1
XTAL_IN: C124.2, C126.2, IC101.17 (XTAL_IN), R144.2
Y_OUT: IC101.22 (Y_OUT), R145.1

Notes on the sheet:
11.0V 1.6V Pk-Pk 3.6MHz triangle
9.1V 1.6V Pk-Pk
89V
106V 440V Pk-Pk 60Hz + 15.7kHz
-0V 28.8V Pk-Pk 15.7kHZ
-0.5V 11V Pk-Pk 15.7kHz
0.1V
0.3V 1.4V Pk-Pk
3.4V 0.4V Pk-Pk
0.9V
-80V 180V Pk-Pk 60Hz
12.6V 2V Pk-Pk
18V 2.4V Pk-Pk
-0.2V 30V Pk-Pk 15.7kHz
DEFLECTION
8.5V 7.6V Pk-Pk 60Hz+15kHz
3.3V
3.9V
0.1V 51V Pk-Pk 60Hz
-2V 36V RMS / 140V Pk-Pk 15.7kHz
-1.0V (!?)
115V >900V Pk-Pk 15.7kHz
1.3V 2.3V Pk-Pk
0.0V 7.9V Pk-Pk 15.7kHz
-9V 240V Pk-Pk 15.7kHZ
1.2V 15V Pk-Pk 60Hz
0.3V 0.8V Pk-Pk
1.1V 1.7V Pk-Pk
18.5V 1.2V Pk-Pk 60Hz
Soldered on bottom side of PCB
8.5V 1.3V Pk-Pk 15.7kHz
3.3V 1.1V Pk-Pk
-80.5V 188V Pk-Pk
1.5V 2.6V Pk-Pk
13.3V 2V Pk-Pk
PWB-PWR FILTER POWER FILTER PCB
105V 188V Pk-Pk 60Hz
0.8V 8.4V Pk-Pk
13.5V 0.8V Pk-Pk
121VAC
-0.2V 6V Pk-Pk
-1.1V 176V Pk-Pk 15.7kHz
0V 0.6V Pk-Pk 60Hz
76V 188V Pk-Pk
-81V 184V Pk-Pk 60Hz
0.3V 1.0V Pk-Pk
0V 24V Pk-Pk 15.7kHZ
4.0V
-2.4V 5.2V Pk-Pk
-0.4V 1.6V Pk-Pk 60Hz
-77.5V 188V Pk-Pk
-78V 208V Pk-Pk 60Hz
105V 300V Pk-Pk
1.1V 50V Pk-Pk 60Hz
0.5V 1.7V Pk-Pk 60Hz
3.6V
PWB-CONTROL PCB
5.8V 0.3V Pk-Pk 3.6MHz sine
-80V 180V Pk-Pk
0.8V 1.5V Pk-Pk 15.7kHz
25.0V
26.6V 29V Pk-Pk 60Hz
11.0V 0.8V Pk-Pk 3.6MHz triangle
10V 22.4V Pk-Pk 60Hz
-4.6V 184V Pk-Pk
0.7V 1.8V Pk-Pk 60Hz
1.2V 0.3V Pk-Pk
-12V 180V Pk-Pk
4.8V 188V Pk-Pk
3.4V 4.4V RMS / 10V Pk-Pk 15.7kHz
Please check that you have the latest version of this schematic from: https://github.com/fredsa/apple-color-monitor-iie-a2m2056 Flyback and other transformer configurations may be drawn incorrectly. Report any corrections to this schematic to: fredsa@gmail.com I've spent many hours recreating this 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
41V
186V
4.6V 1.6V Pk-Pk
-5.0V 184V Pk-Pk
-10V 186V Pk-Pk 60Hz 5V Pk-Pk 15.7kHz
13.2V 1.6V Pk-Pk
PWR SWITCH PCB
6.5V 2.0V Pk-Pk
4.8 - 5.6V (COLOR ADJ) 0.4V (TEXT SWITCH) 0.4V Pk-Pk
3.6V 3.6V RMS / 2.3V Pk-Pk 15.7kHz
-75V 180V Pk-Pk 60Hz
11.0V 0.8V Pk-Pk 60Hz sawtooth
4.4V 4.4V RMS / 2.6V Pk-Pk 15.7kHz
79V 188V Pk-Pk 60Hz
3.7V
-2V 224V Pk-Pk 15.7kHZ
1.1V 8V Pk-Pk
-2.0V 9.6V Pk-Pk 60Hz
FRED WAS HERE
-30V 9.0V Pk-Pk 15.7kHz
2.3V
18.4V
0.3V 0.08 Pk-Pk
PWB-CRT SOCKET NECK BOARD
8.0V 1.7V Pk-Pk 60Hz sawtooth
11.1V 1.2V Pk-Pk
POWER LED PCB
JUMPER SANDBOX
11.8V 0.1V Pk-Pk
69V 188V Pk-Pk
3.7V 4.0V RMS / 5.5V Pk-Pk 15.7kHz
0.1V 0.6V Pk-Pk 15.7kHz
8.3V 7.0V Pk-Pk 60Hz+15kHz
86V 24V Pk-Pk 60Hz
VIDEO AMPLICATION
68V 188V Pk-Pk
26.2V
1.2V 7.8V Pk-Pk 15.7kHz
11.3V
SERVICE SWITCH
12.8V 2V Pk-Pk
9.0V 1.6V Pk-Pk
3.8V
3.4V 1V Pk-Pk
-71V 184V Pk-Pk
-1.3V 13.3V Pk-Pk 60Hz
X-RAY PROTECTION
1.2V
4.5V 3.0V Pk-Pk
189V 1V Pk-Pk
-0.2V 6.2V RMS / 22V Pk-Pk 15.7kHz
8.5V 3.5V Pk-Pk 60Hz+15kHz
-0.01V 43V Pk-Pk 15.7kHz
26V 0.8V Pk-Pk 15.7kHz
78V 188V Pk-Pk 60Hz
1.7V
150V
0V 27V Pk-Pk 60Hz+15.7kHz
105V 268V Pk-Pk
8.2V 1.6V Pk-Pk
-14.5V 344V Pk-Pk 11.5kHz
5.8V 0.2V Pk-Pk 3.6MHz sine
TEXT/GFX SWITCH PCB
28V
187V 0V Pk-Pk
1.5V 1.9V Pk-Pk 15.7kHz
69.1V 188V Pk-Pk
-80V 184V Pk-Pk
0.7V 1.1V Pk-Pk 60Hz+15.7kHz
CHROMA / LUMINANCE
0.7V 1.6V Pk-Pk 60Hz
1.7V 27V Pk-Pk 60Hz
26V 2.4V Pk-Pk 60Hz
157V 28V Pk-Pk 60Hz
68.4V 188V Pk-Pk
0.4V 27V Pk-Pk 60Hz+15.7kHz
1.4V 9.6V Pk-Pk
8.0V 2V Pk-Pk
-0.7V 176V Pk-Pk 15.7kHz
3.0V 2.6V Pk-Pk 60Hz sawtooth
VIDEO SIGNAL PROCESSING
LIVE
ISOLATED
