fredsa/apple-color-monitor-iie-a2m2056/(commit log)

2026-06-06 Initial commit, partially reverse engineered
    [apple-color-monitor-iie-a2m2056.kicad_sch]
2026-06-27 Added final power filter PCB
    [apple-color-monitor-iie-a2m2056.kicad_sch]
2026-06-28 neck board cleanup
    [apple-color-monitor-iie-a2m2056.kicad_sch]
2026-06-28 Updated comments
    [apple-color-monitor-iie-a2m2056.kicad_sch]
2026-06-28 +36VAC power
    [apple-color-monitor-iie-a2m2056.kicad_sch]
2026-06-28 component values
    [apple-color-monitor-iie-a2m2056.kicad_sch]
2026-06-28 Cleanup and publish SVG/PDF
    [apple-color-monitor-iie-a2m2056.kicad_sch]
2026-06-28 Add front control panel PCB layout
    [apple-color-monitor-iie-a2m2056.kicad_sch]
2026-06-29 Fix typo, updated notes.
    [apple-color-monitor-iie-a2m2056.kicad_sch]
2026-07-09 Fix PCB photo layers
2026-07-09 Include chassis no in README.md
